hamuel89/Senior-Design/Documents/D1 Poster .pptx

1.01- Ingram Readymix Inc.

Ahmed Al Qaysi, Nicholas Holleman, Andres Oliva
Sponsor: Mr. Charlie Tuttle

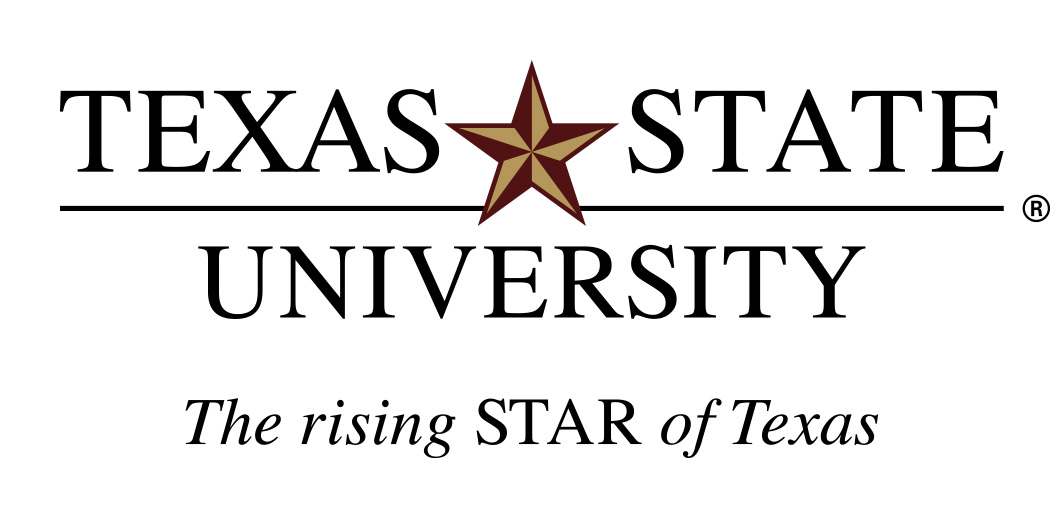
[picture p1: figure]
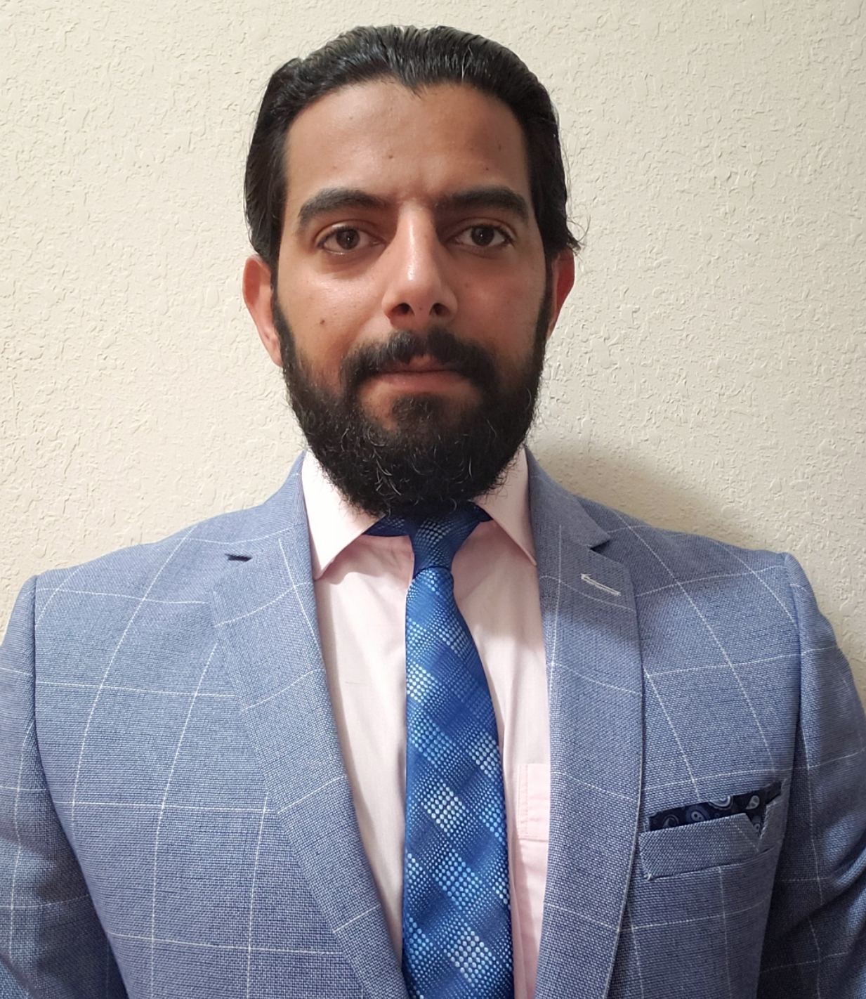
[picture p2: figure]
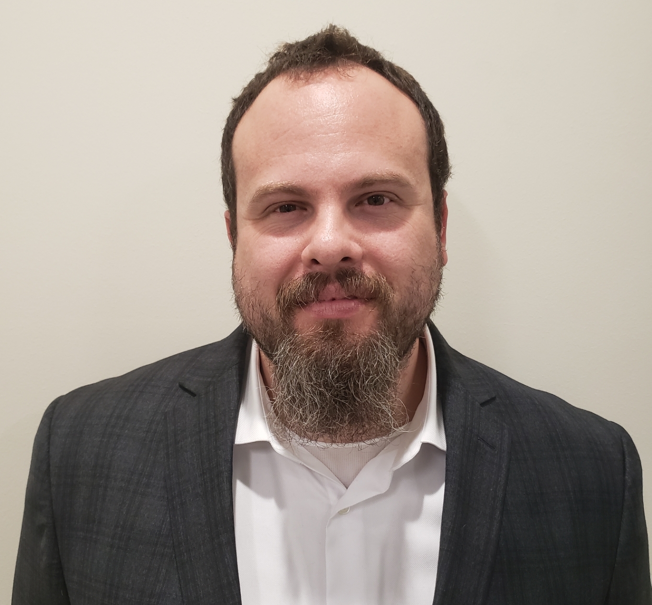
[picture p3: figure]
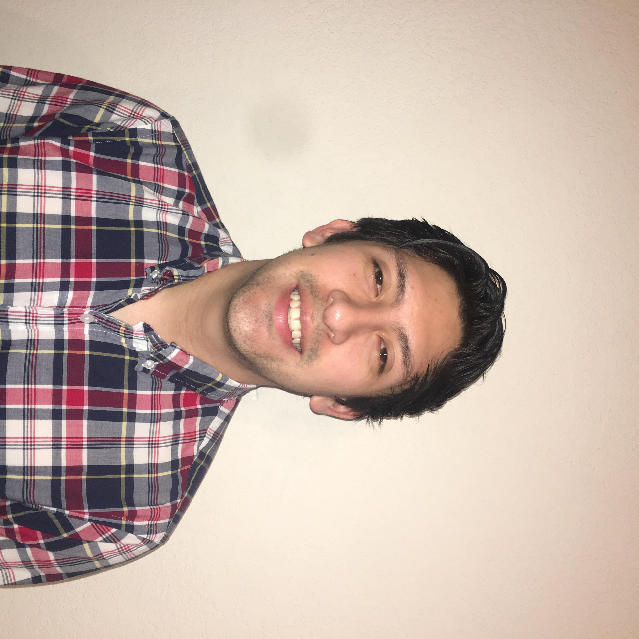
[picture p4: figure]
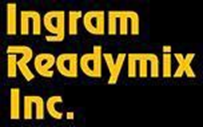
[picture p5: figure]

The Project

The Ingram Readymix project is an ongoing effort to develop an exhaust water monitoring system for a cement plant. This is a highly software-oriented project that will self-diagnose and analyze hardware components that make up the system at the facility’s water retention pond.

Power Management

Requirements:
- 5 days of power without solar.
Hardware needed:
- SleepyPi and relays.

Starting from left to right:
- The first subsystem is located at the water retention pond.
- The second subsystem consist of the energy components.
- The third subsystem is located at the office.
The end product will send notifications to the office with a time stamp to notify employees of an outflow event in a timely manner. This will be beneficial to the company to prevent any sort of possible future fines.

Project Overview

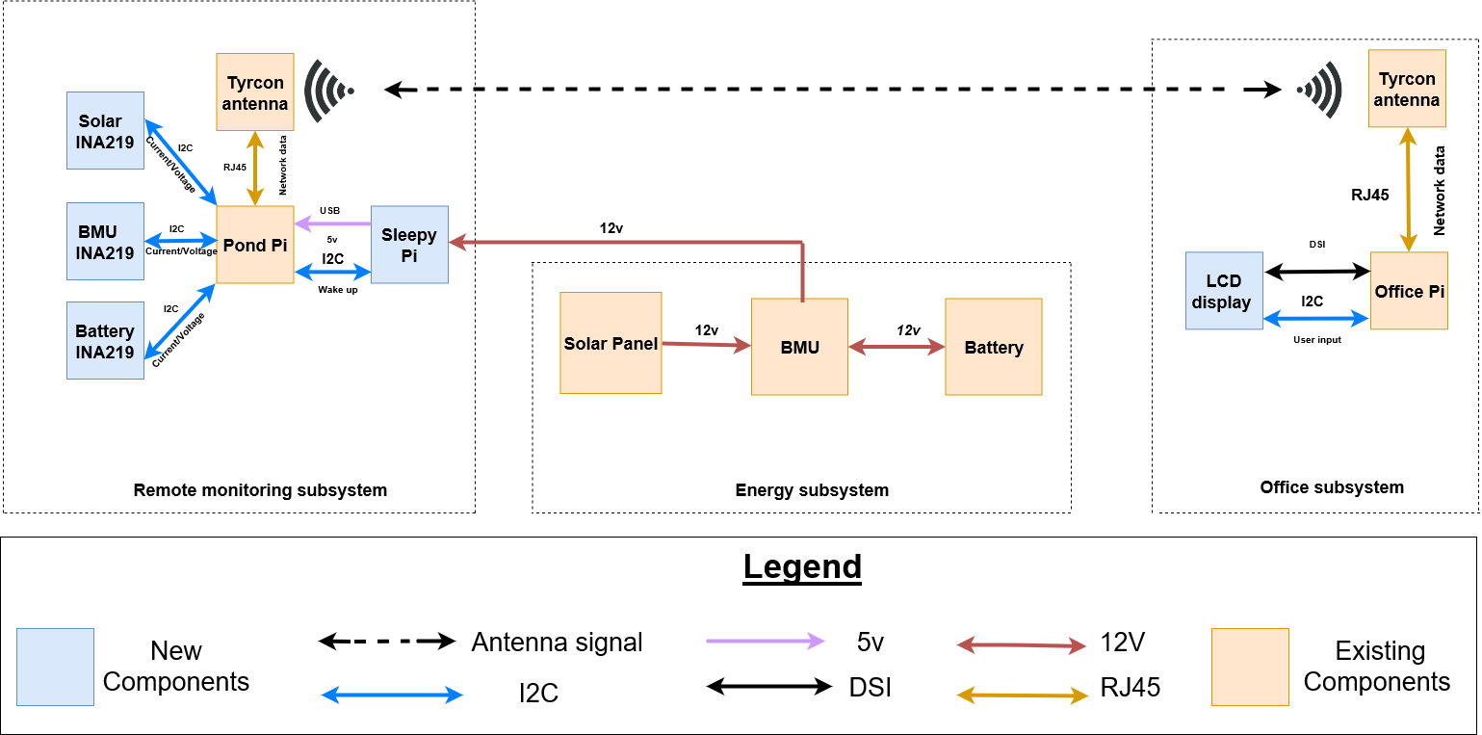
[picture p6: figure]

Data Log (Block Chain)

- The TCEQ permit requires Ingram Readymix Inc. to maintain data log entries for a minimum of 3 years.
- More block chain systems can be implemented due to its expandability.
- This system will be able to detect corruption upon data entry.

User Case

The user case flow chart is an example of what a general user would see when using the system. This will be an interactive graphical user interface (GUI) where the diagnostic operation will start.

Goals

- Diagnostic of system errors and recommended solutions.
- Create a private blockchain for log data assurance.
- Power management and system analysis.

Stretch Goals

- Incorporate a modem to allow the user to interact with the system remotely.
- Include sensors from other design projects for further analysis.

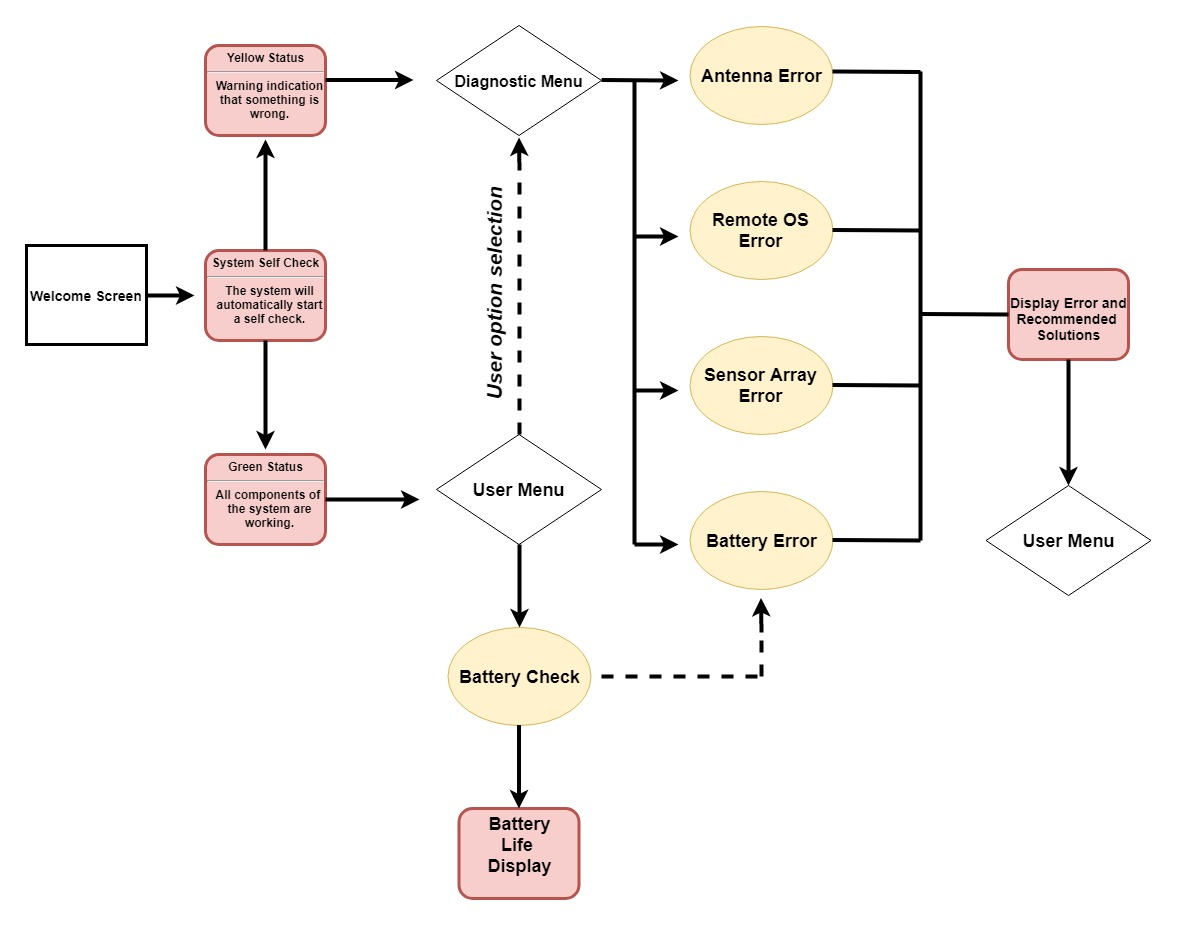
[picture p7: figure]
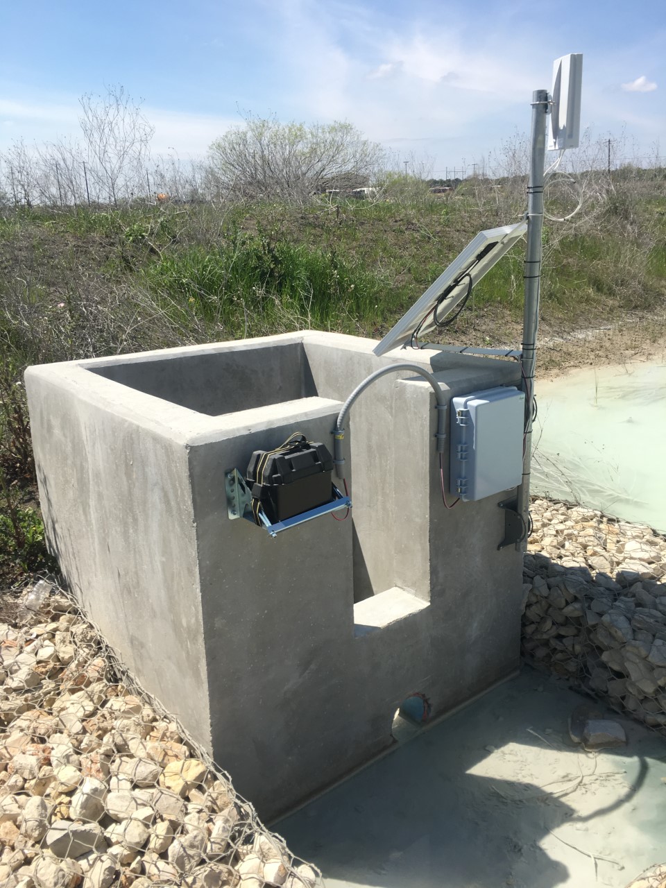
[picture p8: figure]
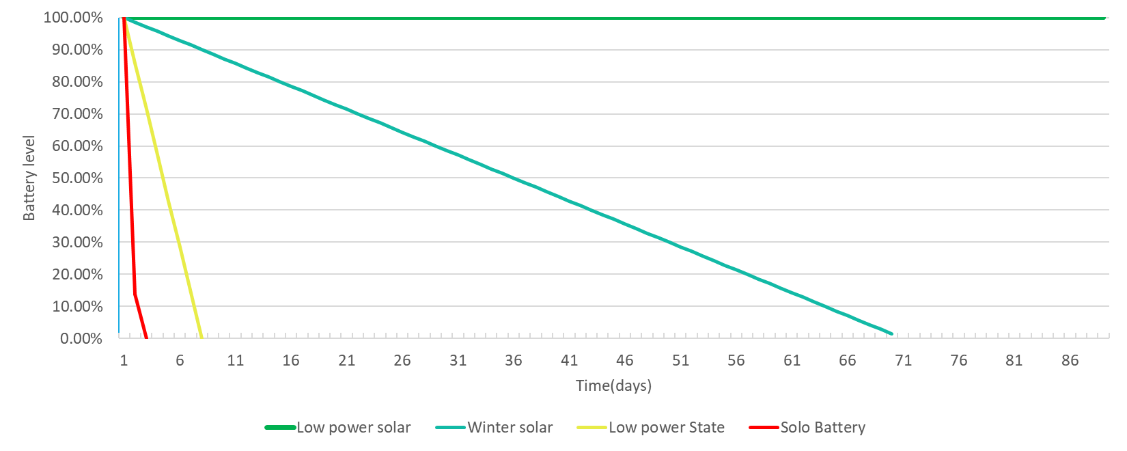
[picture p9: figure]
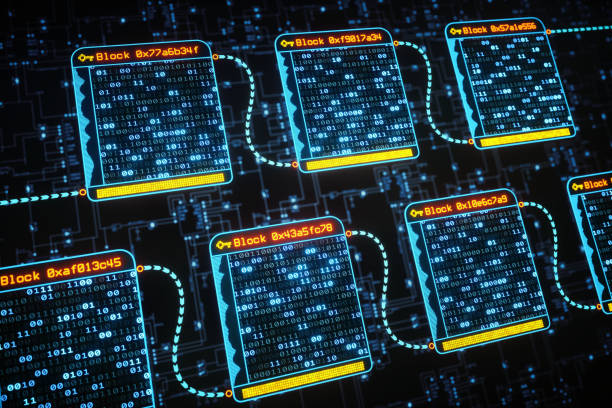
[picture p10: figure]
A circuit board Description generated with very high confidence
