hamuel89/Senior-Design/Documents/D2 Poster.pptx

E2.01- Ingram Readymix Secured Network

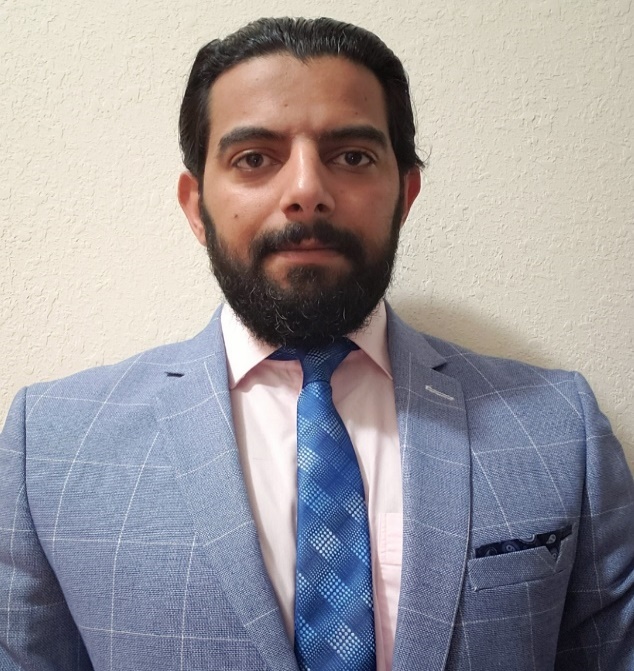
[picture p11: figure]
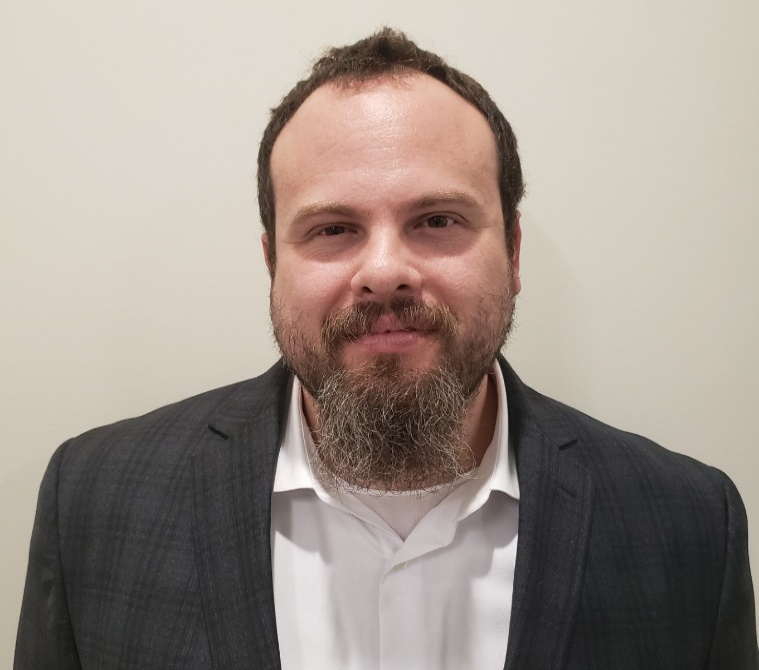
[picture p12: figure]
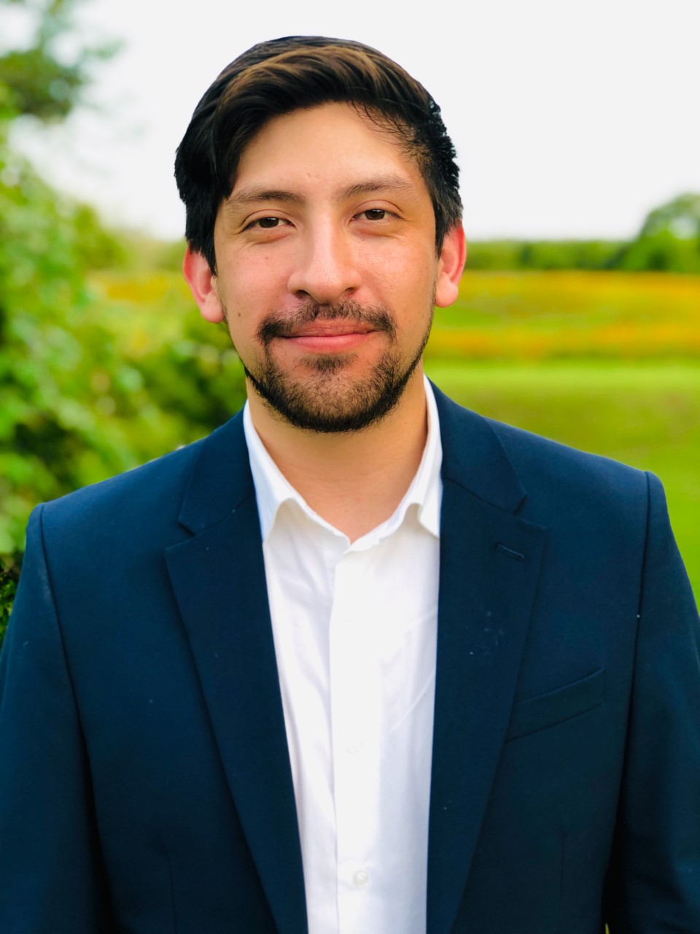
[picture p13: figure]

The Project

Our project upgrades a remote retention pond with new hardware and software. This includes:
- Power management
- Blockchain ledger
- Graphical user interface
- Encryption (Security)

Motivation

The Ingram Readymix facility is under a TCEQ permit that requires the plant to report a water sample within 30 minutes when water leaves through a storm drain.

Hardware

Ahmed Al Qaysi, Nicholas Holleman, Andres Oliva
Sponsor: Mr. Charlie Tuttle

Hardware Design

Remote Retention Pond Flow Chart

Requirements & Results

Features | Requirements | Data
Data Ledger | Verifiable data record. Store 3 years of records | Storage size: 1.85 Gbytes

Power Management | 3-day minimum battery life

Communication | Neglects unauthorized transmissions. | Retransmitted Blocks: 1.2% Time to Transmit: 1.02 seconds
Overall System | Samples sensor every 30 seconds.

Graphical User Interface | Display past and current water level, Battery life, 3 Clicks maximum to any location within GUI

Acknowledgements

Dr. Stan McClellan
Mr. Mark Walker
Mr. Charlie Tuttle

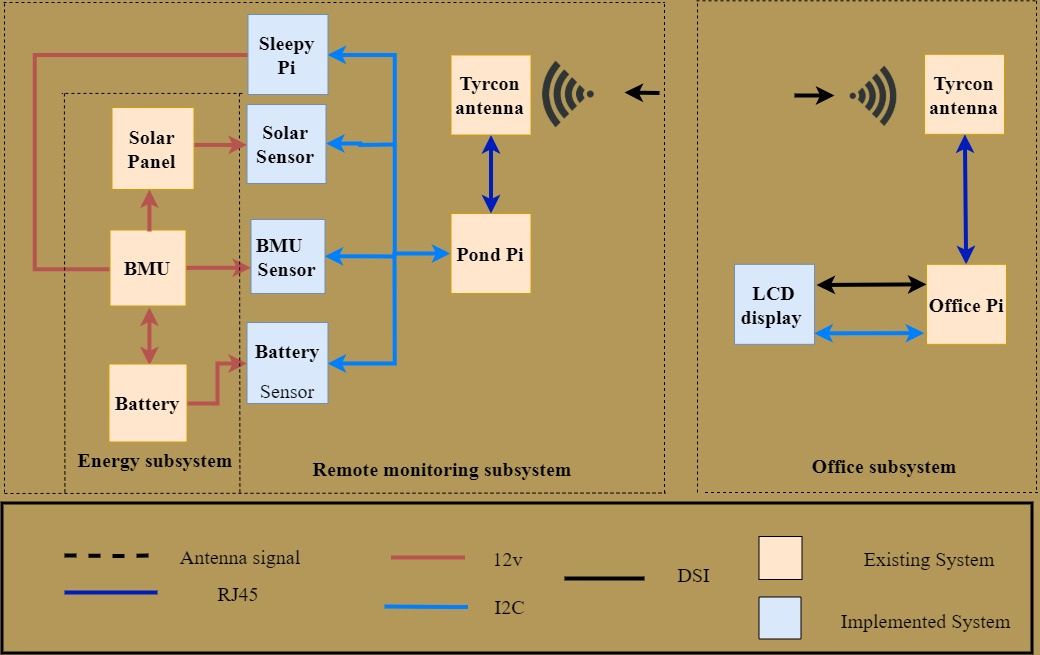
[picture p14: figure]

Both Devices are located in a IP65 rated box at the Pond.

Hardware Implemented:
- Microcontroller
- RTC
- Sleep Mode
- LCD
- Replace LED strip
- Pass-Present data
- Sensors
- Battery life
- Voltage
- Current

Microprocessor

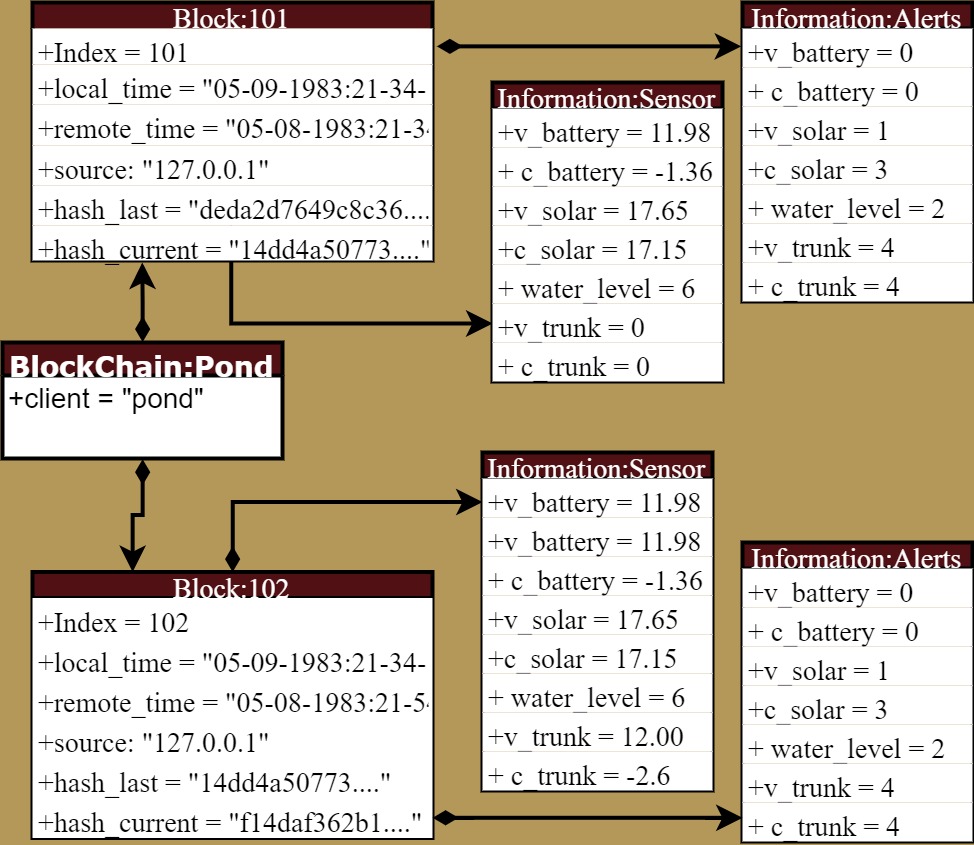
[picture p15: figure]
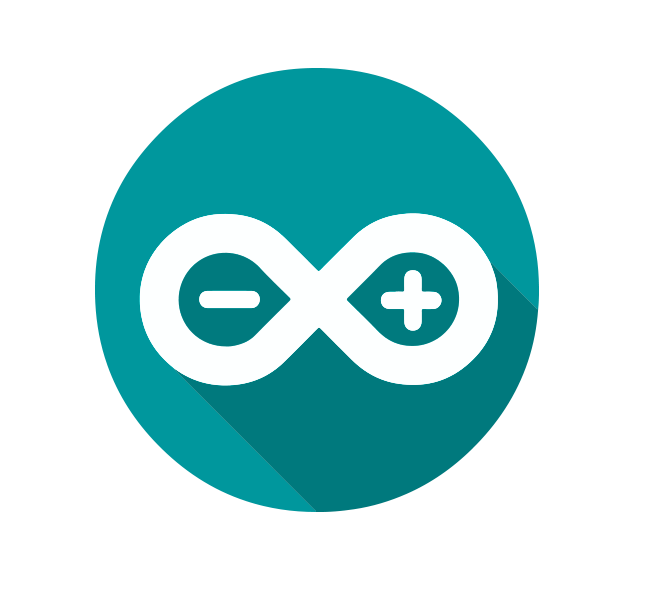
[picture p16: figure]

Microcontroller

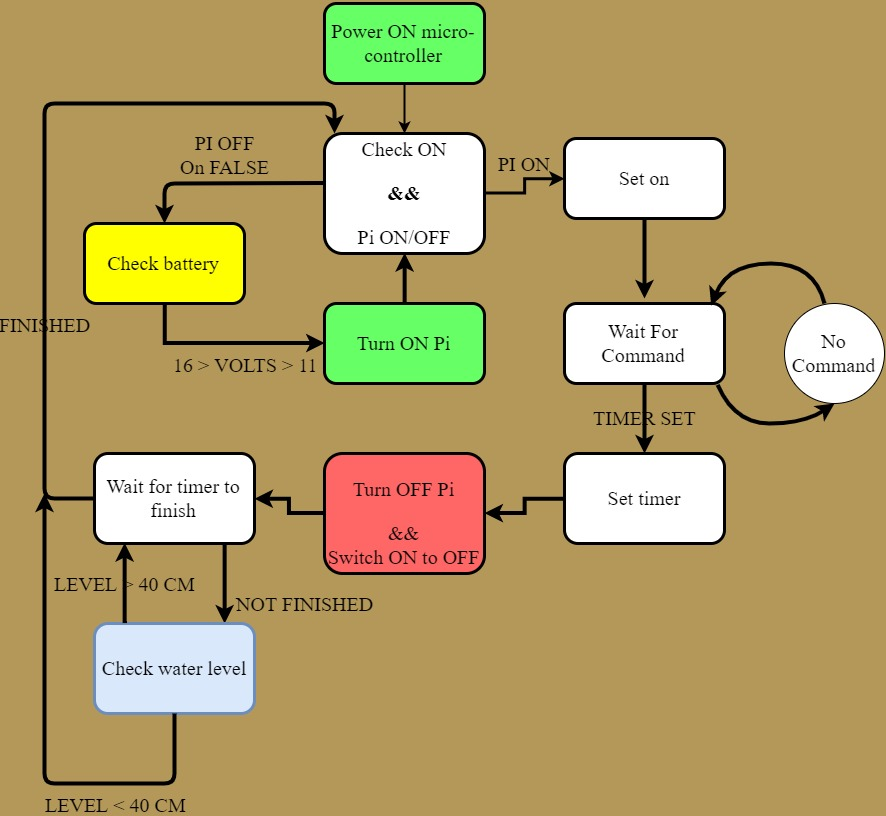
[picture p17: figure]

- Communication
- I2C
- UART
- Power Management
- Relay control

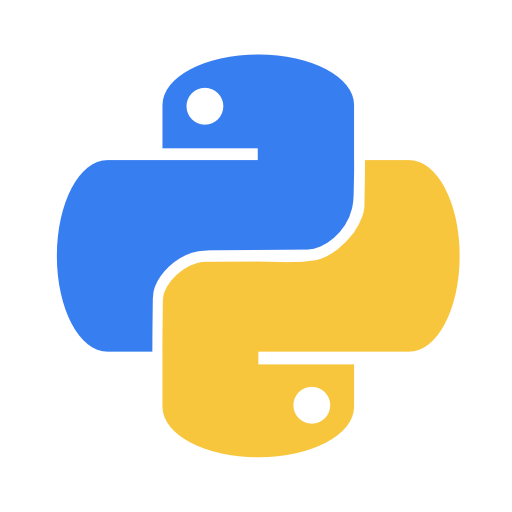
[picture p18: figure]
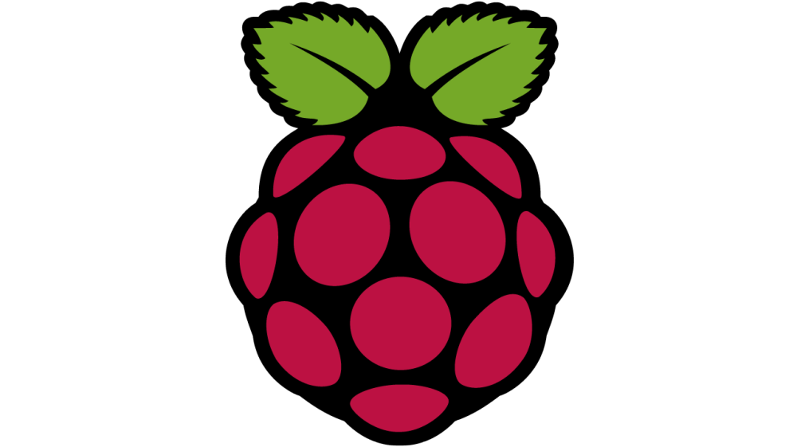
[picture p19: figure]
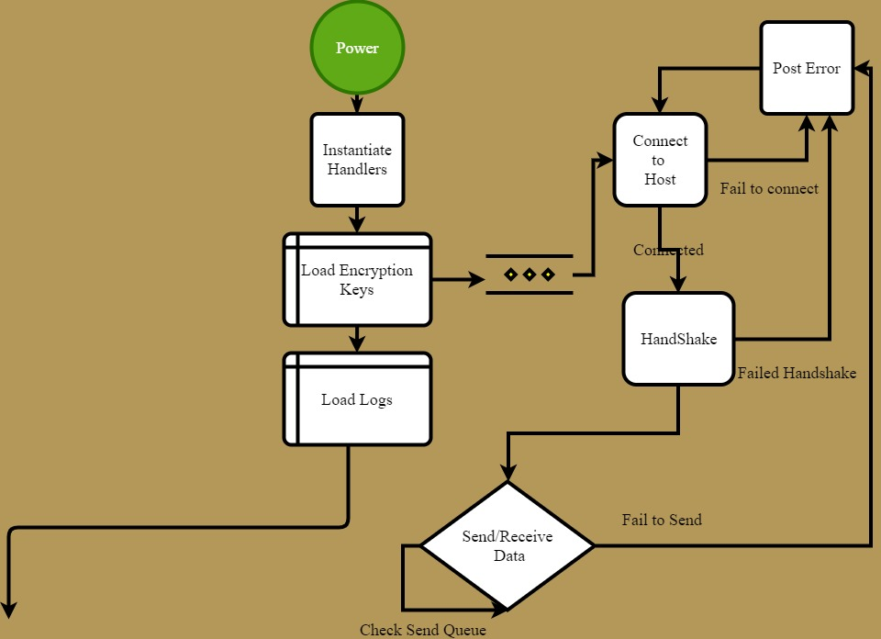
[picture p20: figure]
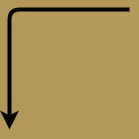
[picture p21: figure]
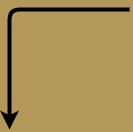
[picture p22: figure]
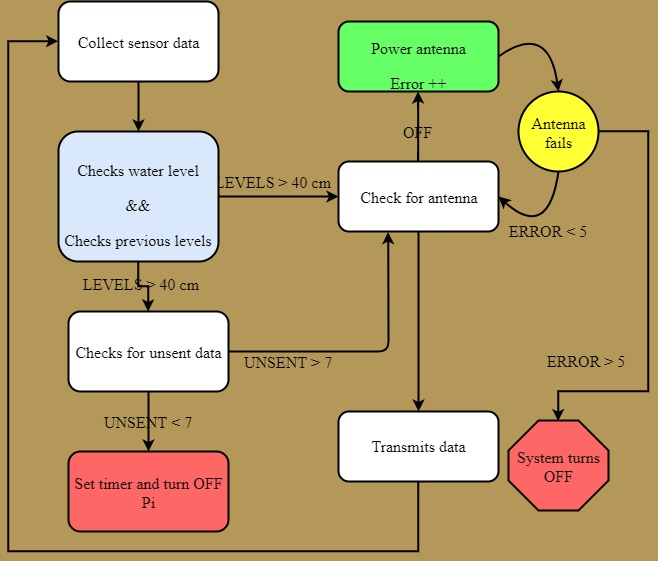
[picture p23: figure]

- Network Communication
- TCP
- Encryption : RSA
- I2C
- Microcontroller management
- Data Ledger
- Block Chain
- Error Handling
- Sensors
- Network
- Power Subsystem

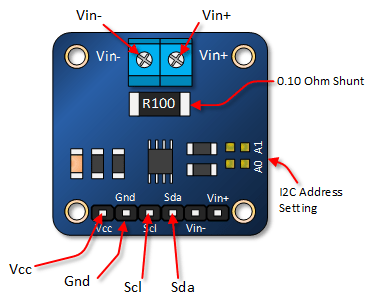
[picture p24: figure]
Image result for INA219 sensor
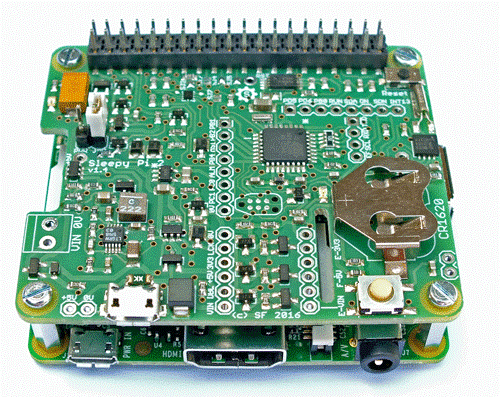
[picture p25: figure]
Image result for sleepy pi microcontroller
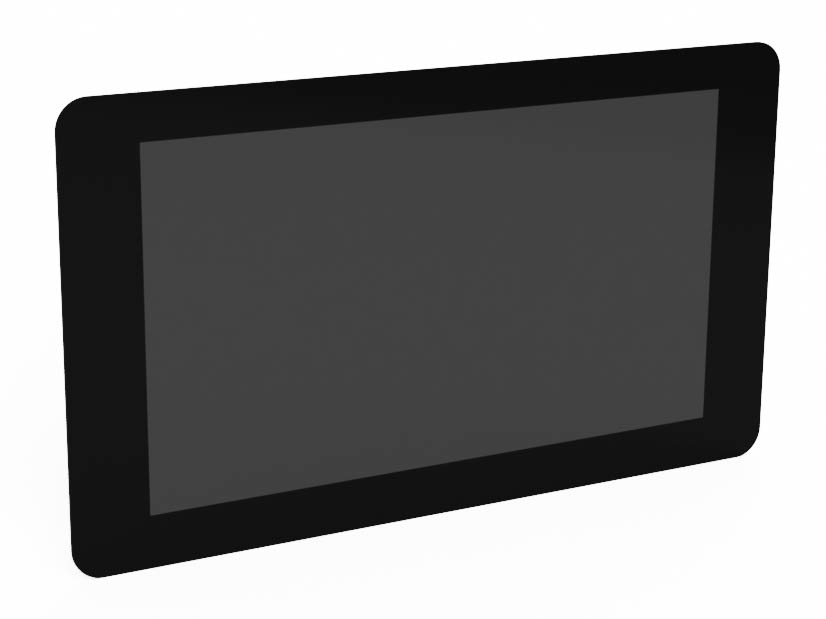
[picture p26: figure]

- Protection
- Over-voltage shutdown
- Under-voltage lockout
